arduino-guay/ESP32-AG_Sinte/AG_AKWF.hpp

#ifndef  AG_AKWF_h
#define  AG_AKWF_h

#include <Arduino.h>

const int16_t AKWF_piano_0009[1024] = {
   676,  1968,  3504,  4906,  6241,  7695,  9192, 10566, 11854,
 13153, 14418, 15562, 16633, 17697, 18709, 19625, 20500, 21373, 22196,
 22939, 23658, 24380, 25051, 25654, 26238, 26822, 27360, 27844, 28317,
 28779, 29196, 29572, 29934, 30279, 30580, 30852, 31123, 31381, 31604,
 31808, 32020, 32219, 32382, 32520, 32642, 32729, 32765, 32767, 32746,
 32672, 32537, 32365, 32160, 31905, 31606, 31278, 30920, 30511, 30057,
 29576, 29057, 28484, 27867, 27231, 26562, 25846, 25095, 24328, 23531,
 22692, 21820, 20925, 19999, 19035, 18059, 17083, 16115, 15166, 14266,
 13439, 12688, 12030, 11482, 11047, 10704, 10448, 10279, 10175, 10102,
 10042,  9984,  9908,  9786,  9610,  9381,  9086,  8716,  8273,  7757,
  7158,  6482,  5744,  4958,  4123,  3256,  2383,  1525,   688,  -113,
  -856, -1532, -2144, -2692, -3169, -3578, -3927, -4210, -4424, -4572,
 -4654, -4661, -4592, -4451, -4247, -3982, -3669, -3322, -2955, -2578,
 -2206, -1862, -1548, -1264, -1014,  -804,  -622,  -459,  -319,  -208,
  -111,   -12,    85,   163,   240,   329,   428,   523,   628,   758,
   910,  1061,  1210,  1361,  1510,  1642,  1748,  1831,  1886,  1910,
  1919,  1921,  1920,  1923,  1950,  2017,  2132,  2296,  2512,  2792,
  3135,  3545,  4023,  4565,  5167,  5828,  6537,  7284,  8058,  8847,
  9630, 10374, 11051, 11646, 12144, 12524, 12767, 12865, 12820, 12641,
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
 -7809, -8168, -8535, -8895, -9232, -9548, -9860,-10173,-10469,-10744,
-11004,-11255,-11493,-11723,-11956,-12187,-12404,-12614,-12829,-13048,
-13265,-13477,-13686,-13894,-14106,-14318,-14520,-14714,-14908,-15105,
-15296,-15476,-15652,-15823,-15988,-16153,-16319,-16484,-16639,-16785,
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
};

#endif
